Sanchit1112/Foldable-Robots-Team-2/index.md

---
title: Foldable Robots Project
---

# Project Title: Snake-like Bio-inspired Degradable Robot

**Team 2**

| Name | Email |
| --- | --- |
| Sanchit Singhal | _sanchitsinghal@asu.edu_ |
| Kevin Julius |_kmjulius@asu.edu_ |
| Romney Kellogg |_rakello1@asu.edu_ |
| Siddhaarthan Akila Dhakshinamoorthy | _sakiladh@asu.edu_  |

# Research Question : How can a snake-inspired biodegradable robot be created using foldable robotics principles?

* [Develop A Research Question](/Develop_A_Research_Question_Team_2.md)

* [Biomechanics Background and Initial Specifications](/Biomechanics_Background_and_Initial_Specifications.md)

* [System Kinematics](/SystemKinematics.md)

* [System Dynamics](/SystemDynamics.md)

* [System Optimization](/Design_Optimization/SystemOptimization.md)

* [Manufacturing Planning](DesignandManufacturingWorkflow-1/DesignandManufacturingWorkflow-1.md)

* [Experimental Validation](DataCollectionandExperimentalValidation/DataCollectionandExperimentalValidation.md)

* [Presentation I](/presentation1.md)

* [Presentation II](/presentation2.md) 

* [Presentation III](/presentation3.md) 
  
* [Bibliography](/Bibliography.md)

# Additional Pages: 

* [Data](Data/Data.md)

* [Video/Image Gallery](/Gallery/Gallery.md)

* [CAD and Other Design Files](/CAD/CAD.md)

* [Additional Code](/AddCode/AddCode.md)
