Sanchit1112/Foldable-Robots-Team-2/Bibliography.md

---
title: Bibliography
---

## Bibliography
1. H. Marvi, J. Bridges, and D. L. Hu, “Snakes Mimic Earthworms: propulsion using rectilinear travelling waves,” The Royal Society, vol. 10, no. 84, Jul. 2013. 
1. B. C. Jayne, “Kinematics of Terrestrial Snake Locomotion,” JSTOR, vol. 1986, no. 4, pp. 915–927, Dec. 1986. 
1. L. Paez, M. Granados and K. Melo, "Conceptual design of a modular snake origami robot," 2013 IEEE International Symposium on Safety, Security, and Rescue Robotics (SSRR), Linkoping, pp. 1-2, 2013.
1. J. M. Woltering, “From Lizard to Snake; Behind the Evolution of an Extreme Body Plan,” Current Genomics, vol. 13, no. 4, pp. 289–299, Jul. 2012. 
1.E. Vander Hoff, Donghwa Jeong and Kiju Lee, "OrigamiBot-I: A thread-actuated origami robot for manipulation and locomotion," 2014 IEEE/RSJ International Conference on Intelligent Robots and Systems, Chicago, IL, pp. 1421-1426, 2014.
1. W. Tang, F. Reyes and S. Ma, "Study on rectilinear locomotion based on a snake robot with passive anchor," 2015 IEEE/RSJ International Conference on Intelligent Robots and Systems (IROS), Hamburg, pp. 950-955, 2015.
1. Bruce C Jayne, What Defines Different Modes of Snake Locomotion?, Integrative and Comparative Biology, Volume 60, Issue 1, July 2020, Pages 156–170, 
1. Z.Y. Bayraktaroglu, Snake-like locomotion: Experimentations with a biologically inspired wheel-less snake robot, Mechanism and Machine Theory, Volume 44, Issue 3, 2009, Pages 591-602
1. C. D. Onal, R. J. Wood and D. Rus, "An Origami-Inspired Approach to Worm Robots," in IEEE/ASME Transactions on Mechatronics, vol. 18, no. 2, pp. 430-438, April 2013, doi: 10.1109/TMECH.2012.2210239.
1. H. W. LISSMANN, Rectilinear Locomotion in a Snake (Boa Occidentalis) Journal of Experimental Biology. 1950, 26, Pages 368-379
“Celebrating Wildlife and Wild Places,” Welcome to the Racine Zoo. [Online]. Available: https://www.racinezoo.org/western-hognose-fact-sheet. [Accessed: 08-Feb-2021]. 
1. D.Aukes, “Approximating compliant beams with the pseudo-rigid-body model,”egr557. Accessed: March. 19, 2021 [Online]. Available: https://egr557.github.io/modules/compliance/generated/prbm.html
1. D.Aukes, “Cantilever Beams,”egr557. Accessed: March. 19, 2021 [Online]. Available: https://egr557.github.io/modules/compliance/cantilever-beams.html 
1. D.Aukes, “Euler-Bernoulli Beams,”egr557. Accessed: March. 19, 2021 [Online]. Available: https://egr557.github.io/modules/compliance/generated/euler-bernoulli-beams/euler-bernoulli-beams.html 
1. “Servo Motor SG-90 Basics, Pinout, Wire Description, Datasheet,” Components101. [Online]. Available: https://components101.com/motors/servo-motor-basics-pinout-datasheet. [Accessed: 20-Mar-2021]. 

Up-to-date as of 4/22/2021
