Sanchit1112/Foldable-Robots-Team-2/presentation3.md

<iframe width="560" height="315" src="https://www.youtube.com/embed/bImJaabd9gw" title="YouTube video player" frameborder="0" allow="accelerometer; autoplay; clipboard-write; encrypted-media; gyroscope; picture-in-picture" allowfullscreen></iframe>
