Sanchit1112/Foldable-Robots-Team-2/presentation2.md

<iframe width="560" height="315" src="https://www.youtube.com/embed/z5Vl53PlTG8" title="YouTube video player" frameborder="0" allow="accelerometer; autoplay; clipboard-write; encrypted-media; gyroscope; picture-in-picture" allowfullscreen></iframe>
