Sanchit1112/Foldable-Robots-Team-2/Gallery/Gallery.md

## Video/Image Gallery 

### First Prototype Test

<iframe width="560" height="315" src="https://www.youtube.com/embed/2SPLT6BGT5A" title="YouTube video player" frameborder="0" allow="accelerometer; autoplay; clipboard-write; encrypted-media; gyroscope; picture-in-picture" allowfullscreen></iframe>

### Component Fit Test



### Solidworks Drawings of Assembly

draw 2

draw1

### Unfolded Assembly

unfolded1

unfolded2

### Folded Assembly

folded
