Sanchit1112/Foldable-Robots-Team-2/AddCode/AddCode.md

## Robot Servo Control Code

[Robot Servo Control](/servo_motor.ino)

## All other relevant code is within the corresponding sections that used that code
