Sanchit1112/Foldable-Robots-Team-2/CAD/CAD.md

## CAD and Manufacturing Files

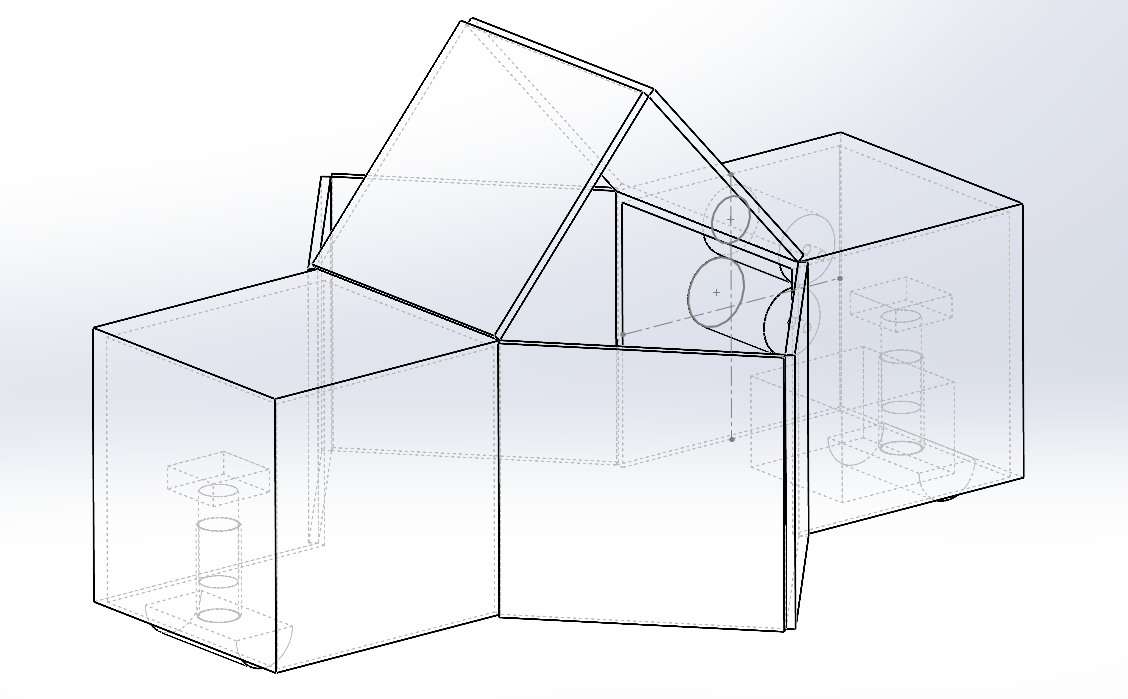
[picture p26: CAD/cad1.PNG]

* [Final Assembly SOLIDWORKS Files](/Final_Solidworks.zip)

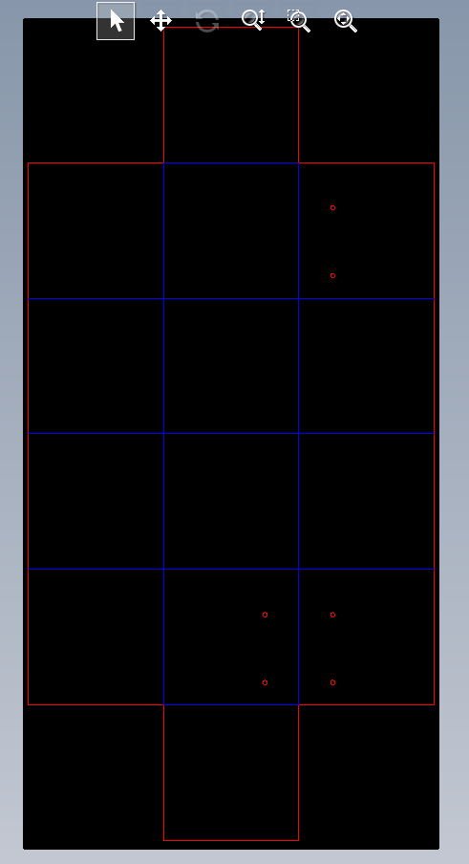
[picture p27: CAD/cad2.PNG]

* [Manufacturing YAML File](/bro.yaml)
* [Manufacturing DXF File](/design2.dxf)
