Sanchit1112/Foldable-Robots-Team-2/SystemDynamicsPrep_files/Damp4.PNG

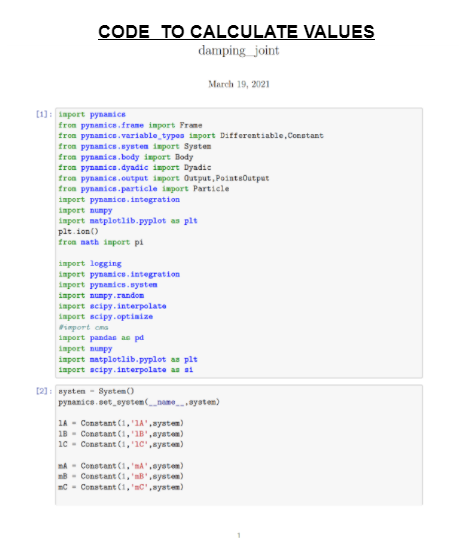
SystemDynamicsPrep_files/Damp4.PNG
