Sanchit1112/Foldable-Robots-Team-2/CAD/design.dxf

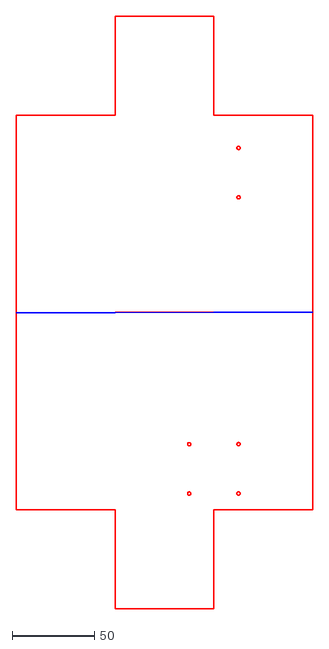
[picture p55: CAD file, 2021-04-23]
CAD/design.dxf
180.0 x 360.0
