Sanchit1112/Foldable-Robots-Team-2/CAD/design2.dxf

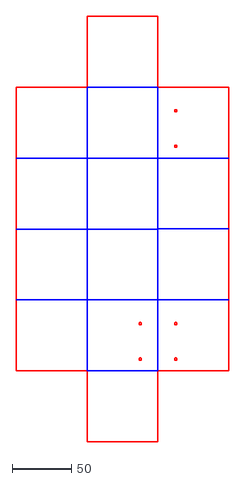
[picture p56: CAD file, 2021-04-23]
CAD/design2.dxf
180.0 x 360.0
