Sanchit1112/Foldable-Robots-Team-2/(commit log)

2021-03-28 Update index.md
    Updating System Kinematics
2021-03-28 Add files via upload
    Images for Kinematics.md
